kmosti/3d-print-business-card/personal.example.scad

// Fictional example details. Copy this file to personal.scad (gitignored) and edit the copy.

// Front text
name_text     = "JORDAN EXAMPLE";
title_text    = "People & Culture";
subtitle_text = ["Organisational Development", "for small teams"];  // a string, or a list for several lines
phone_text    = "+47 000 00 000";
email_text    = "jordan@example.com";

// Front QR code; "" shows an empty placeholder frame
qr_message = "https://example.com";

// Back contact QR code (vCard); empty optional fields are omitted
vcard_first_name = "Jordan";
vcard_last_name  = "Example";
vcard_org        = "";
vcard_title      = "";
vcard_url        = "";
