kmosti/3d-print-business-card/(commit log)

2026-10-08 feat: add parametric 3D-printable business card
    [business_card.scad, personal.example.scad]
2026-10-08 fix: display back qr code in preview
    [business_card.scad]
2026-10-08 feat: support subtitle > 1 line
    [business_card.scad, personal.example.scad]
2026-10-08 refactor: share personal details and vCard via contact.scad
    [business_card.scad, contact.scad]
2026-10-08 feat: add desk stand for a stack of cards
    [card_holder.scad]
2026-10-08 feat: add carry case with name and contact QR inlays
    [card_case.scad]
2026-10-22 feat: print back QR code behind a solid cover layer
2026-10-22 feat: hold case lid with a snap detent instead of friction
    Add a lead-in chamfer on the lip and a fit-test export with only the rims.
2026-10-22 feat: print case inlays behind a solid cover layer
2026-10-22 feat: reduce card case clearance
